bocamobile/board-mini/mini-base/design-files/MINI-BASE-A001-1.0.0-Pinout.pdf

Tabelle1

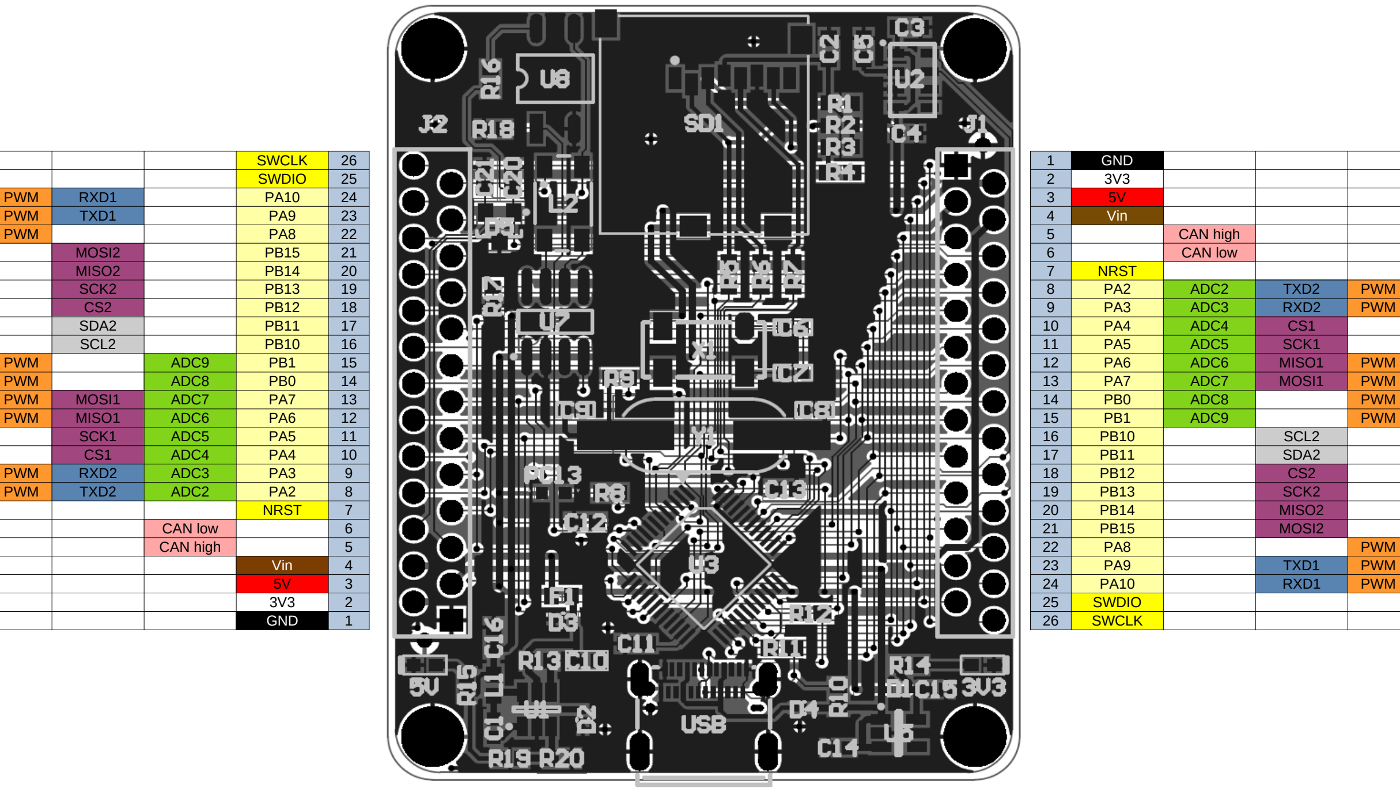
[picture p15: figure]
SWCLK; GND; SWDIO; PWM; RXD1; TXD1; Vin; CAN high; MOSI2; CAN low; MISO2; NRST; SCK2; ADC2; TXD2; ADC3; RXD2; SDA2; ADC4; SCL2; ADC5; SCK1; ADC9; ADC6; MISO1; ADC8; ADC7; MOSI1

Seite

1

PHYSICAL PIN
PIN NAME
CONTROL
ANALOG
USART
SPI
I2C
CAN BUS
PWM
