bocamobile/board-mini/mini-bike/documentation/Pinout_List.ods

Dashboard |  |  | ECU grey |  |  | ECU black
Pin | Description | Function | Pin | Description | Function | Pin | Description | Function
1 | B/R | Speed Sensor Vcc | 1 | G | Ignition Coil 4 | 1 | B/W | GND
2 | B/Lg | Fuel Pump Sig | 2 | B/W | GND | 2 | B/Br | Signal Ground ???
3 | Dbr | Meter Switch Down | 3 | W/R | rear connector thingy ??? | 3 | W/G | HO2 Sensor
4 | Dg | Meter Switch Up | 4 | B/Y | Clutch Switch / Starter Motor | 4 | Dg | IAT Sensor
5 | - | - | 5 | B/W | GND | 5 | B/Bl | ECT Sensor
6 | P | Speed Sensor Sig | 6 | Bl | Gear Position Switch / strange box thingy | 6 | B | TO Sensor
7 | Y/Bl | to ECM grey Pin 26 | 7 | B/W | GND | 7 | - | -
8 | B/G | to ECM black Pin 14 | 8 | O/Bl | Handlebar Switch UP | 8 | - | -
9 | G/Y | Oil Pressure Switch | 9 | Br/Y | to Dash Pin 10 | 9 | B/Lg | STVA
10 | Br/Y | to ECM grey Pin 9 | 10 | O/Bl | Immobilizer | 10 | G | STVA
11 | O/G | Fuse Box 4 (Signal) | 11 | Gr | rear connector thingy ??? | 11 | W | Steering Damper
12 | R/Bl | Fuse Box 5 (Fuel) | 12 | - | - | 12 | Br | Steering Damper
13 | Y | Headlight(HI) | 13 | Y | Ignition Coil 3 | 13 | Y/R | Cooling Fan Relay / Fuel Pump
14 | Bl/B | strange box thingy | 14 | Lg | Secondary Injector 1 | 14 | B/G | to Dash Pin 8
15 | B/Bl | Turn Signal Right | 15 | Lg/W | Secondary Injector 2 | 15 | P | Gear Position Switch
16 | B | Turn Signal left | 16 | Lg/B | Secondary Injector 3 | 16 | G/Bl | CKP Sensor
17 | - | - | 17 | Lg/Bl | Secondary Injector 4 | 17 | G/Y | AP Sensor
18 | - | - | 18 | W/G | Pair Control Valve | 18 | G/B | IAP Sensor
19 | - | - | 19 | Y/G | Starter Button / Starter Motor | 19 | Y/W | STP Sensor
20 | B/W | GND | 20 | R/Y | Immobilizer | 20 | - | -
 |  |  | 21 | Bl/W | rear connector thingy ??? | 21 | Bl/G | rear connector thingy ???
 |  |  | 22 | Bl/B | rear connector thingy ??? | 22 | Bl/Y | rear connector thingy ??? | Dealer Mode Switch???
 |  |  | 23 | O/R | Handlebar Switch DOWN | 23 | Y | EXCVA
 |  |  | 24 | Br | ISC Valve | 24 | R/B | EXCVA
 |  |  | 25 | W/Bl | Ignition Coil 1 | 25 | O/G | rear connector thingy ??? / distributor ???
 |  |  | 26 | B | Ignition Coil 2 | 26 | Y/Bl | to Dash Pin 7
 |  |  | 27 | Gr/W | Primary Injector 1 | 27 | R/Bl | Cooling Fan Relay / Fuse 5 (Fuel) / distributor ???
 |  |  | 28 | Gr/B | Primary Injector 2 | 28 | G/W | CKP Sensor
 |  |  | 29 | Gr/Y | Primary Injector 3 | 29 | B/Y | CMP Sensor
 |  |  | 30 | Gr/R | Primary Injector 4 | 30 | R | Sensor Supply ??? / rear connector thingy ???
 |  |  | 31 | G/R | Cooling Fan Relay | 31 | P/B | TP Sensor
 |  |  | 32 | W/B | HO2 Sensor | 32 | B/W | GND
 |  |  | 33 | Y/B | Cooling Fan Relay | 33 | P/W | STVA
 |  |  | 34 | Bl | ISC Valve | 34 | W/B | STVA
 |  |  | 35 | Y | ISC Valve | 35 | P | Speed Sensor
 |  |  | 36 | G | ISC Valve | 36 | B/R | EXCVA
