bocamobile/board-mini/mini-base/pictures/mini-base-rear.png

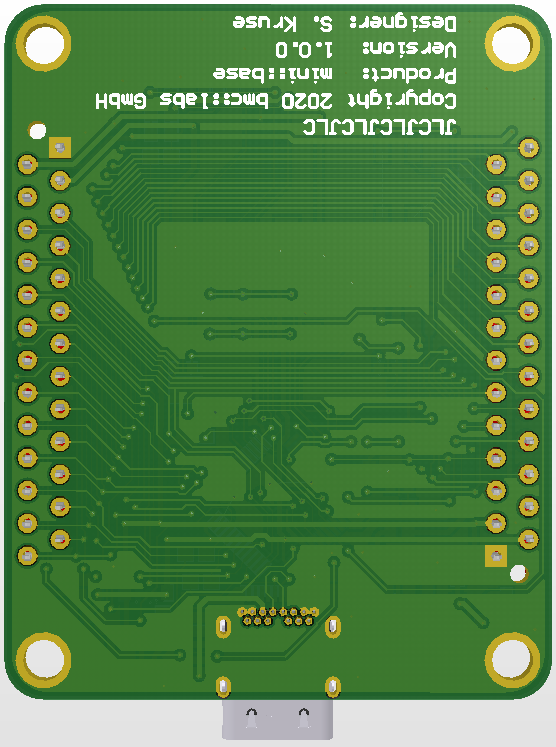
mini-base/pictures/mini-base-rear.png
