bocamobile/board-mini/mini-bike/documentation/gsxr 1000 pinout.jpg

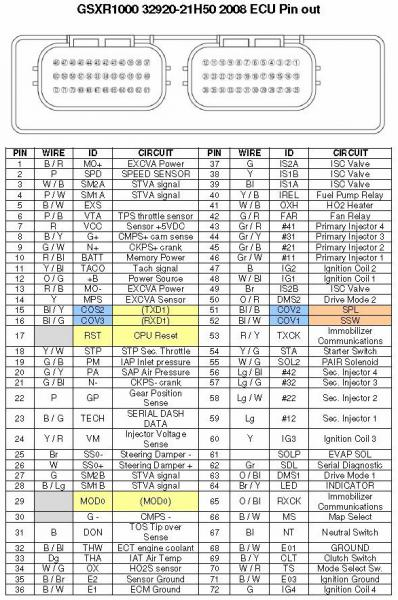
mini-bike/documentation/gsxr 1000 pinout.jpg
