bocamobile/board-mini/mini-grid/pictures/mini-grid-pinout.png

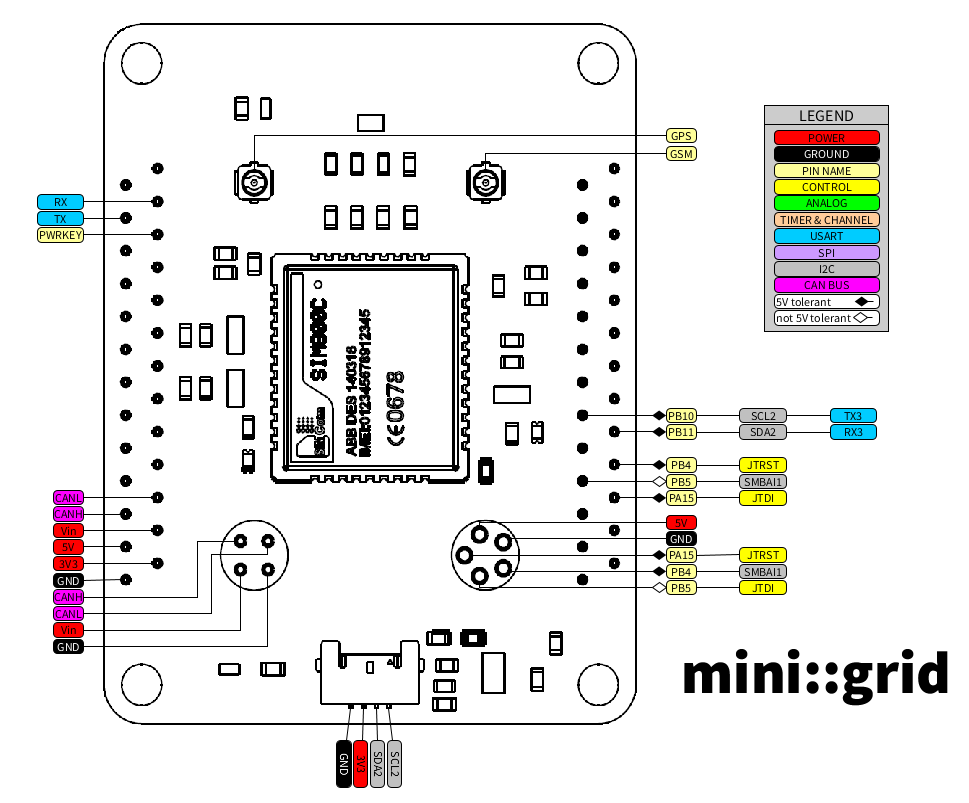
mini-grid/pictures/mini-grid-pinout.png
