bocamobile/board-mini/mini-grid/pictures/mini-grid-rear.png

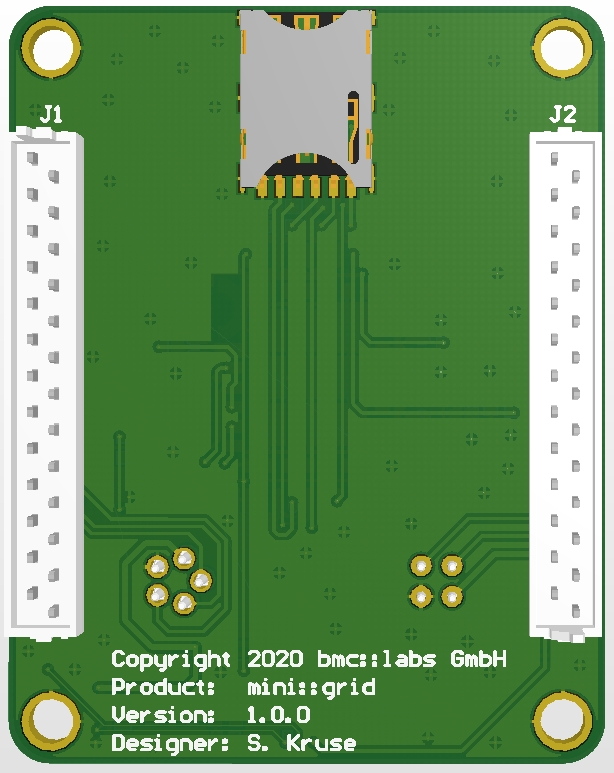
mini-grid/pictures/mini-grid-rear.png
