bocamobile/board-mini/mini-out/pictures/mini-out-pinout.png

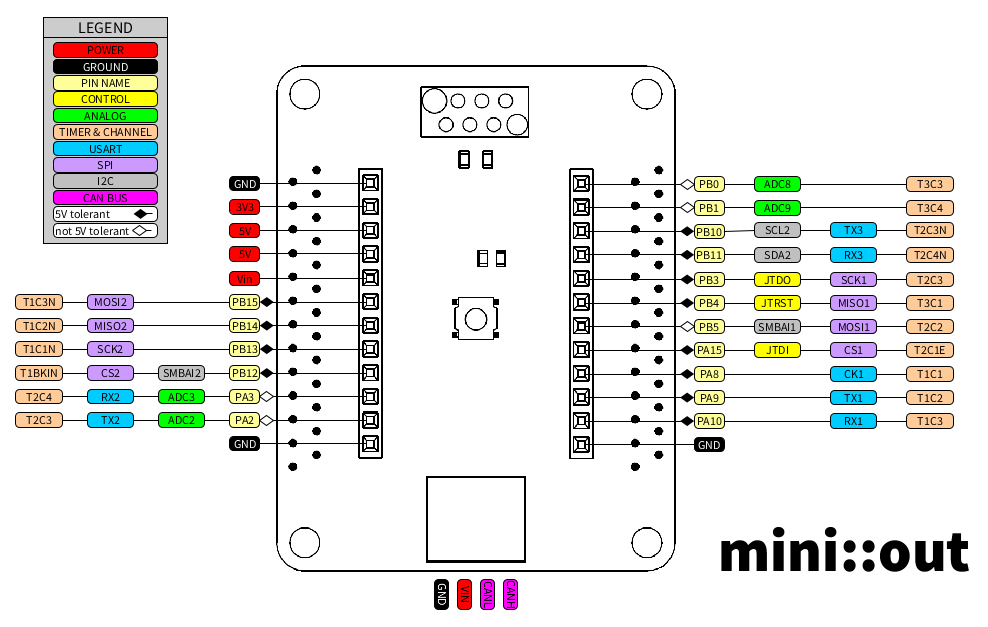
mini-out/pictures/mini-out-pinout.png
