bocamobile/board-mini/mini-out/pictures/mini-out-rear.png

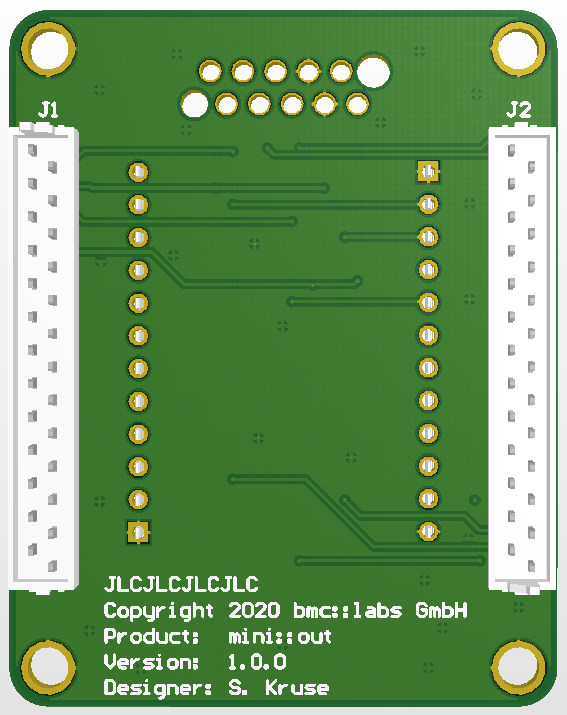
mini-out/pictures/mini-out-rear.png
