bocamobile/board-mini/mini-pit/pictures/mini-pit-pinout.png

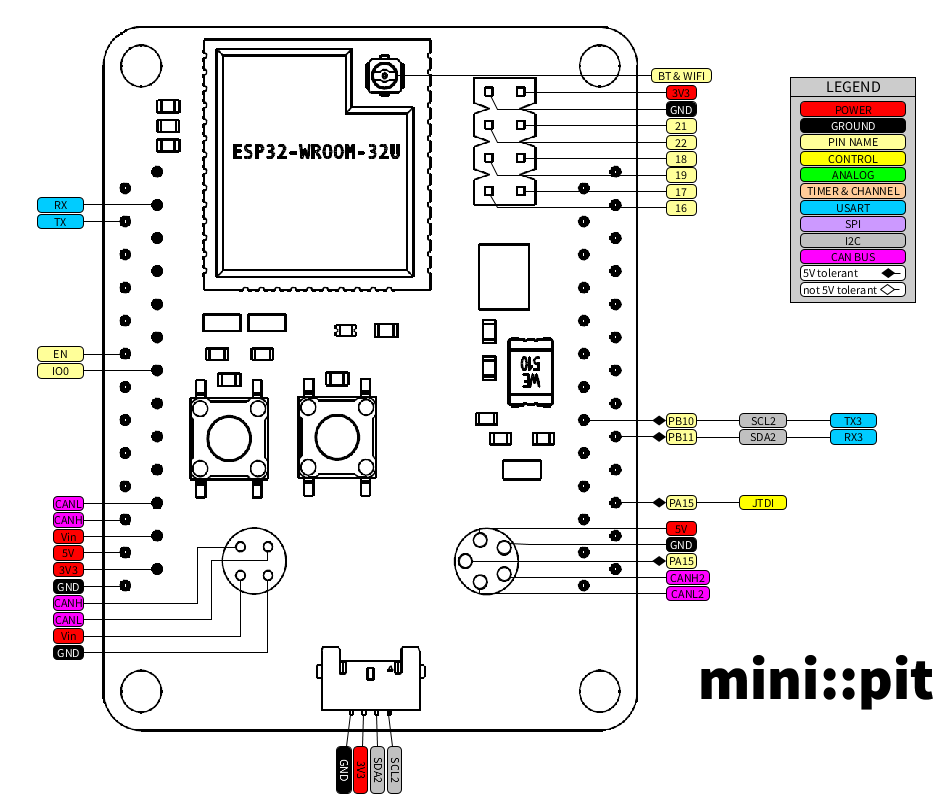
mini-pit/pictures/mini-pit-pinout.png
