bocamobile/board-mini/mini-pit/pictures/mini-pit-rear.png

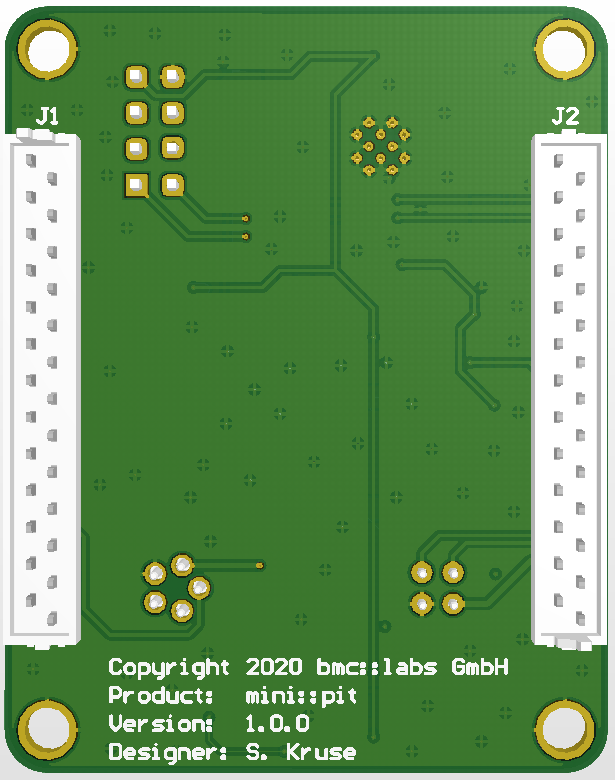
mini-pit/pictures/mini-pit-rear.png
