bocamobile/board-mini/mini-bike/production-files/MINI-BIKE-A001-1-0-0-BOM.xls

Comment | Description | Designator | Footprint | LibRef | Quantity
100nF | CL10 Series 0.1 uF 16 V ±10% Tolerance X7R SMT Multilayer Ceramic Capacitor | C1, C3 | PCB-ul7goghxin8pri3xfob7-1 | CMP-4ca9852e0e1c936e-3 | 2
0.47uF | CAP CER 0.47UF 16V 10% X5R 0603 | C2 | CAPC1608X90X35LL15T15 | CMP-126210-2 | 1
BAT54T1G | Schottky Barrier Diode, 2-Pin SOD-123, Pb-Free, Tape and Reel | D1 | ONSC-SOD-123-2-425-04_V | CMP-4964594-3 | 1
Würth Elektronik 690357102672 | Male THT Straight Connector without Latch and with Polarization WR-MM, 26 pins | J1, J2 | PCB-qkngfwumds4pa5a4mwtz-1 | CMP-cccf062e80c51308-1 | 2
Molex 34830-0801 | MX150 2x4 Dual Row Right-Angle Header, 8 Circuits, Keying Option A, Black, Solder Tail | J3 | PCB-1mpzuevuzgsguukkiqai-1 | CMP-e95d221892b7369a-5 | 1
510R | Thick Film Resistors - SMD 0603 510ohms 5% Tol | R1 | RESC1608X55X30LL15T15 | CMP-3654705-2 | 1
STMicroelectronics E-L9637D013TR | L9637 Series 36 V 2.3 mA Monolithic Bus Driver with ISO 9141 Interface - SOIC-8 | U1 | PCB-xa77rof92k761hx1v7rk-1 | CMP-9137583754b04ef0-1 | 1
