bocamobile/board-mini/mini-out/production-files/BOM-PartType-MINI-OUT-A001-1-0-0.xls

 |  | Component list |  | MINI::OUT
 |  | Source Data From: |  | MINI-OUT-A001-1-0-0.PrjPcb
 |  | Project: |  | MINI-OUT-A001-1-0-0.PrjPcb
 |  | Variant: |  | None
 |  | Report Date: | 04.11.2020 | 15:53:02
Description | Manufacturer Part Number | Designator | Quantity | Description | Comment
SQ Post Socket, Through-hole, Vertical, -55 to 105 degC, 2.54 mm Pitch, 12-Pin, Female, RoHS | SSW-112-01-T-S | J4, J5 | 2 | SQ Post Socket, Through-hole, Vertical, -55 to 105 degC, 2.54 mm Pitch, 12-Pin, Female, RoHS | SSW-112-01-T-S
Male THT Straight Connector without Latch and with Polarization WR-MM, 26 pins | 690357102672 | J1, J2 | 2 | Male THT Straight Connector without Latch and with Polarization WR-MM, 26 pins | Würth Elektronik 690357102672
WS-TASV SMD Tact Switch 6X6 mm | 430182043816 | RST | 1 | WS-TASV SMD Tact Switch 6X6 mm | 430182043816
Fixed Miniature Connectors, Spring Cage, Horizontal, SMD, 4 pos | 1702474 | J3 | 1 | Fixed Miniature Connectors, Spring Cage, Horizontal, SMD, 4 pos | Phoenix Contact 1702474
Res Thick Film 0603 22 Ohm 5% 1/10W ±200ppm/°C Molded SMD SMD Paper Tape on Plastic Reel |  | R1, R2 | 2 | Res Thick Film 0603 22 Ohm 5% 1/10W ±200ppm/°C Molded SMD SMD Paper Tape on Plastic Reel | Res1
REDFIT IDC SKEDD Connector WR-WST, pitch 2.54 mm, 10 pins |  | JTAG | 1 | REDFIT IDC SKEDD Connector WR-WST, pitch 2.54 mm, 10 pins | Würth Elektronik 490107671012
