bocamobile/board-mini/mini-grid/design-files/MINI-GRID-A001-1-0-0.xls

 |  | Component list |  | <Parameter ProjectName not found>
 |  | Source Data From: |  | MINI-GRID-A001-1-0-0.PrjPcb
 |  | Project: |  | MINI-GRID-A001-1-0-0.PrjPcb
 |  | Variant: |  | None
 |  | Report Date: | 05.11.2020 | 15:18:57
Description | Manufacturer Part Number | Designator | Quantity | Description | Comment
LED WHITE 0603 SMD |  | 1PPS, NET | 2 | LED WHITE 0603 SMD | Vishay VLMW1300-GS08
Soft Orange 0603 160º 15 mA 1.8 V 7.5 mcd Surface Mount LED | TLMO1000-GS08 | 4V | 1 | Soft Orange 0603 160º 15 mA 1.8 V 7.5 mcd Surface Mount LED | Vishay TLMO1000-GS08
0603 10 nF 50 V ±10 % Tolerance X7R SMT Multilayer Ceramic Capacitor | CC0603KRX7R9BB103 | C1 | 1 | 0603 10 nF 50 V ±10 % Tolerance X7R SMT Multilayer Ceramic Capacitor | 10nF
CAP CER 10UF 25V 20% X5R 0603 |  | C2 | 1 | CAP CER 10UF 25V 20% X5R 0603 | 10uF
0603 22 uF 4 V ±20 % Tolerance X5R SMT Multilayer Ceramic Capacitor | 06034D226MAT2A | C3 | 1 | 0603 22 uF 4 V ±20 % Tolerance X5R SMT Multilayer Ceramic Capacitor | AVX 06034D226MAT2A
CAP CER 0.1UF 50V X7R 0603 | CL10B104KB8NNNC | C4, C5, C6, C7, C8, C10 | 6 | CAP CER 0.1UF 50V X7R 0603 | 100nF
Chip Capacitor, 22 pF, +/- 5%, 50 V, -55 to 125 degC, 0603 (1608 Metric), RoHS, Tape and Reel | CC0603JRNPO9BN220 | C9, C11, C12 | 3 | Chip Capacitor, 22 pF, +/- 5%, 50 V, -55 to 125 degC, 0603 (1608 Metric), RoHS, Tape and Reel | Yageo CC0603JRNPO9BN220
Circular Connector, 712 Series, Receptacle, 5, Socket, Solder, Panel Mount Rohs Compliant: Yes |  | CH1 | 1 | Circular Connector, 712 Series, Receptacle, 5, Socket, Solder, Panel Mount Rohs Compliant: Yes | Binder 09 0416 90 05
Schottky Barrier Diode, 2-Pin SOD-123, Pb-Free, Tape and Reel | BAT54T1G | D1 | 1 | Schottky Barrier Diode, 2-Pin SOD-123, Pb-Free, Tape and Reel | BAT54T1G
Quad Array ESD Protection Diodes with Low Clamping Voltage, 5-Pin SC70, Pb-Free, Tape and Reel | SMF05T1G | D2 | 1 | Quad Array ESD Protection Diodes with Low Clamping Voltage, 5-Pin SC70, Pb-Free, Tape and Reel | SMF05T1G
1.00mm Pitch Pico-LockT Surface Mount Header, Right Angle, 1.50mm Height, Positive Side Locks, 4 Circuits | 503763-0491 | DISPLAY | 1 | 1.00mm Pitch Pico-LockT Surface Mount Header, Right Angle, 1.50mm Height, Positive Side Locks, 4 Circuits | Molex 503763-0491
Rf Connectors / Coaxial Connectors SMT Ml Rec Au 50 Ohm W/anti Sldr Wckng Rl | U.FL-R-SMT-1(10) | GPS, GSM | 2 | Rf Connectors / Coaxial Connectors SMT Ml Rec Au 50 Ohm W/anti Sldr Wckng Rl | Hirose U.FL-R-SMT-1(10)
Male THT Straight Connector without Latch and with Polarization WR-MM, 26 pins | 690357102672 | J1, J2 | 2 | Male THT Straight Connector without Latch and with Polarization WR-MM, 26 pins | Würth Elektronik 690357102672
Conn, Nano Sim, Push-Pull, 6pos | 693043020611 | J3 | 1 | Conn, Nano Sim, Push-Pull, 6pos | NanoSIM Conn
POWER LINE IND, 4.7UH, 500MA, 20%; Product Range: TDK - GLFR Series; Inductance: 4.7 |  | L1 | 1 | POWER LINE IND, 4.7UH, 500MA, 20%; Product Range: TDK - GLFR Series; Inductance: 4.7 | 4.7uH
Inductor RF Chip Unshielded Multi-Layer 27nH 5% 100MHz 12Q-Factor Ceramic 500mA 540mOhm DCR 0603 T/R | LQG18HN27NJ00D | L2 | 1 | Inductor RF Chip Unshielded Multi-Layer 27nH 5% 100MHz 12Q-Factor Ceramic 500mA 540mOhm DCR 0603 T/R | Inductor
Circular Connector, 712 Series, Receptacle, 4, Socket, Solder, Panel Mount Rohs Compliant: Yes | 09 0412 80 04 | PWR | 1 | Circular Connector, 712 Series, Receptacle, 4, Socket, Solder, Panel Mount Rohs Compliant: Yes | Binder 09 0412 90 04
KSC Series NPN 200 mW 50 V 100 mA Surface Mount Epitaxial Transistor - SOT-23 | KSC1623LMTF | Q1, Q2, Q3 | 3 | KSC Series NPN 200 mW 50 V 100 mA Surface Mount Epitaxial Transistor - SOT-23 | NPN
Res General Purpose Thick Film 0603 100k Ohm 1% 1/10W ±100ppm/°C Molded Paper T/R | RC0603FR-07100KL | R1 | 1 | Res General Purpose Thick Film 0603 100k Ohm 1% 1/10W ±100ppm/°C Molded Paper T/R | 100k
Res Thick Film 1.6 x 0.8 mm 49.9K Ohm 1% 0.1W(1/10W) 100ppm/ C Molded SMD Paper T/R | RC0603FR-0749K9L | R2 | 1 | Res Thick Film 1.6 x 0.8 mm 49.9K Ohm 1% 0.1W(1/10W) 100ppm/ C Molded SMD Paper T/R | RC0603FR-0749K9L
Thick Film Resistors - SMD 0603 12.7Kohms 1% Tol | ERJ-3EKF1272V | R3 | 1 | Thick Film Resistors - SMD 0603 12.7Kohms 1% Tol | Panasonic ERJ-3EKF1272V
RCA Series 0603 0.1 W 0 O Jumper Surface Mount Thick Film Chip Resistor | RCA06030000ZSEA | R4, R5 | 2 | RCA Series 0603 0.1 W 0 O Jumper Surface Mount Thick Film Chip Resistor | 0 O
Res Thick Film 0603 4.7K Ohm 1% 1/10W ±100ppm/°C Molded SMD Paper T/R |  | R6, R10, R13 | 3 | Res Thick Film 0603 4.7K Ohm 1% 1/10W ±100ppm/°C Molded SMD Paper T/R | 4k7
Surface Mount Thick Film Resistor, RC Series, 47 kohm, 100 mW, - 1%, 50 V, 0603 [1608 Metric] |  | R7, R12, R14 | 3 | Surface Mount Thick Film Resistor, RC Series, 47 kohm, 100 mW, - 1%, 50 V, 0603 [1608 Metric] | 47k
Res General Purpose Thick Film 0603 10K Ohm 1% 1/10W ±100ppm/°C Molded SMD Paper T/R |  | R8 | 1 | Res General Purpose Thick Film 0603 10K Ohm 1% 1/10W ±100ppm/°C Molded SMD Paper T/R | 10K 0603
RES SMD 43 OHM 5% 1/10W 0603 | RC0603JR-0743RL | R9, R11 | 2 | RES SMD 43 OHM 5% 1/10W 0603 | Yageo RC0603JR-0743RL
PANASONIC ERJPA3F22R0V RESISTOR, ERJP, 22 OHM, 0603, 0.25W, 1% | ERJPA3F22R0V | R15, R17, R18 | 3 | PANASONIC ERJPA3F22R0V RESISTOR, ERJP, 22 OHM, 0603, 0.25W, 1% | Panasonic ERJPA3F22R0V
Thick Film Resistors - SMD 1/10watts 120ohms 1% | RK73H1JTTD1200F | R19 | 1 | Thick Film Resistors - SMD 1/10watts 120ohms 1% | KOA Speer RK73H1JTTD1200F
RC Series 0603 0.1 W 10 Ohms 5% ±100 ppm/°C SMT Thick Film Chip Resistor | RC0603JR-0710RL | R20 | 1 | RC Series 0603 0.1 W 10 Ohms 5% ±100 ppm/°C SMT Thick Film Chip Resistor | YAGEO RC0603JR-0710RL
Conv DC-DC Single Step Down 4.5V to 24V 6-Pin SOT-23 T/R |  | U1 | 1 | Conv DC-DC Single Step Down 4.5V to 24V 6-Pin SOT-23 T/R | Monolithic Power Systems MP2359DT-LF-P
Quad Band GSM/GPRS+GNSS Module 850MHz/900MHz/1800MHz/1900MHz 3.4V to 4.4V 77-Pin SMD |  | U2 | 1 | Quad Band GSM/GPRS+GNSS Module 850MHz/900MHz/1800MHz/1900MHz 3.4V to 4.4V 77-Pin SMD | Simcom SIM868
