bocamobile/board-mini/mini-pit/design-files/MINI-PIT-A001-1-0-0.xls

 |  | Component list |  | <Parameter ProjectName not found>
 |  | Source Data From: |  | MINI-PIT-A001-1-0-0.PrjPcb
 |  | Project: |  | MINI-PIT-A001-1-0-0.PrjPcb
 |  | Variant: |  | None
 |  | Report Date: | 05.11.2020 | 15:23:32
Description | #Column Name Error:Manufacturer Part Number | Designator | Quantity | Description | Comment
WS-TASV SMD Tact Switch 6X6 mm |  | boot, EN | 2 | WS-TASV SMD Tact Switch 6X6 mm | 430182043816
CAP CER 0.1UF 50V X7R 0603 |  | C1, C2, C5, C6 | 4 | CAP CER 0.1UF 50V X7R 0603 | 100nF
CAP CER 1000PF 50V 10% X7R 0603 |  | C3, C4 | 2 | CAP CER 1000PF 50V 10% X7R 0603 | Murata GCM188R71H102KA37D
Circular Connector, 712 Series, Receptacle, 5, Socket, Solder, Panel Mount Rohs Compliant: Yes |  | CH1 | 1 | Circular Connector, 712 Series, Receptacle, 5, Socket, Solder, Panel Mount Rohs Compliant: Yes | Binder 09 0416 90 05
PESD2CAN Series 2 Channel Bi-Directional CAN Bus ESD Protection Diode - SOT-23-3 |  | D1 | 1 | PESD2CAN Series 2 Channel Bi-Directional CAN Bus ESD Protection Diode - SOT-23-3 | NXP Semiconductors PESD2CAN,215
1.00mm Pitch Pico-LockT Surface Mount Header, Right Angle, 1.50mm Height, Positive Side Locks, 4 Circuits |  | DISPLAY | 1 | 1.00mm Pitch Pico-LockT Surface Mount Header, Right Angle, 1.50mm Height, Positive Side Locks, 4 Circuits | Molex 503763-0491
Male THT Straight Connector without Latch and with Polarization WR-MM, 26 pins |  | J1, J2 | 2 | Male THT Straight Connector without Latch and with Polarization WR-MM, 26 pins | Würth Elektronik 690357102672
Conn Unshrouded Header HDR 8 POS 2.54mm Solder ST Thru-Hole Carton |  | J3 | 1 | Conn Unshrouded Header HDR 8 POS 2.54mm Solder ST Thru-Hole Carton | TE Connectivity 5-146256-4
SMD Common Mode Line Filter WE-SL1, L = 100 µH |  | L1 | 1 | SMD Common Mode Line Filter WE-SL1, L = 100 µH | 744212101
Circular Connector, 712 Series, Receptacle, 4, Socket, Solder, Panel Mount Rohs Compliant: Yes |  | PWR | 1 | Circular Connector, 712 Series, Receptacle, 4, Socket, Solder, Panel Mount Rohs Compliant: Yes | Binder 09 0412 90 04
KSC Series NPN 200 mW 50 V 100 mA Surface Mount Epitaxial Transistor - SOT-23 |  | Q1, Q2 | 2 | KSC Series NPN 200 mW 50 V 100 mA Surface Mount Epitaxial Transistor - SOT-23 | ON Semiconductor KSC1623LMTF
Res General Purpose Thick Film 0603 10K Ohm 1% 1/10W ±100ppm/°C Molded SMD Paper T/R |  | R1, R2, R6 | 3 | Res General Purpose Thick Film 0603 10K Ohm 1% 1/10W ±100ppm/°C Molded SMD Paper T/R | Yageo RC0603FR-0710KL
Thick Film Resistors - SMD 1/10W 100ohm 5% |  | R3 | 1 | Thick Film Resistors - SMD 1/10W 100ohm 5% | Yageo AC0603JR-07100RL
Metal Film Resistors 10K OHM .1% 25PPM |  | R4 | 1 | Metal Film Resistors 10K OHM .1% 25PPM | Panasonic ERA-3YEB103V
Surface Mount Thick Film Resistor, Aec-Q200 Erj Series, 1 Kohm, 200 Mw, - 1%, 150 V |  | R5 | 1 | Surface Mount Thick Film Resistor, Aec-Q200 Erj Series, 1 Kohm, 200 Mw, - 1%, 150 V | Res1
RESISTOR, 681R, 0603, FULL REEL |  | R8 | 1 | RESISTOR, 681R, 0603, FULL REEL | Panasonic ERA3AEB6810V
Automotive Catalog 3.3 V CAN Transceiver, 17 mA, -40 to 125 degC, 8-pin SOIC (D), Green (RoHS & no Sb/Br) |  | U1 | 1 | Automotive Catalog 3.3 V CAN Transceiver, 17 mA, -40 to 125 degC, 8-pin SOIC (D), Green (RoHS & no Sb/Br) | SN65HVD230QD
Relay SSR 15mA 1.4V DC-IN DC-OUT 4-Pin SO T/R |  | U2 | 1 | Relay SSR 15mA 1.4V DC-IN DC-OUT 4-Pin SO T/R | TLP175A
SMD Module, ESP32-D0WD, 32MBITS Spi Flash, Uart Mode, U.fl Antenna Connector |  | U3 | 1 | SMD Module, ESP32-D0WD, 32MBITS Spi Flash, Uart Mode, U.fl Antenna Connector | Espressif Systems ESP32-WROOM-32U
LED WHITE 0603 SMD |  | USR LED | 1 | LED WHITE 0603 SMD | Vishay VLMW1300-GS08
