bocamobile/board-mini/mini-grid/design-files/MINI-GRID-A001-1-0-0.PDF

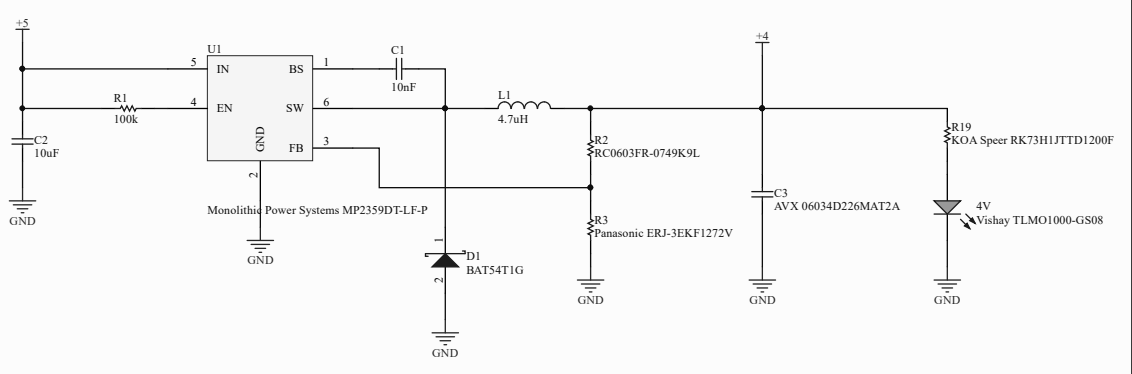
[picture p24: page 1]
Sheet o; ian Kru; GND 2; wer Sy; tems MP2; ic ERJ-3; A Speer RK

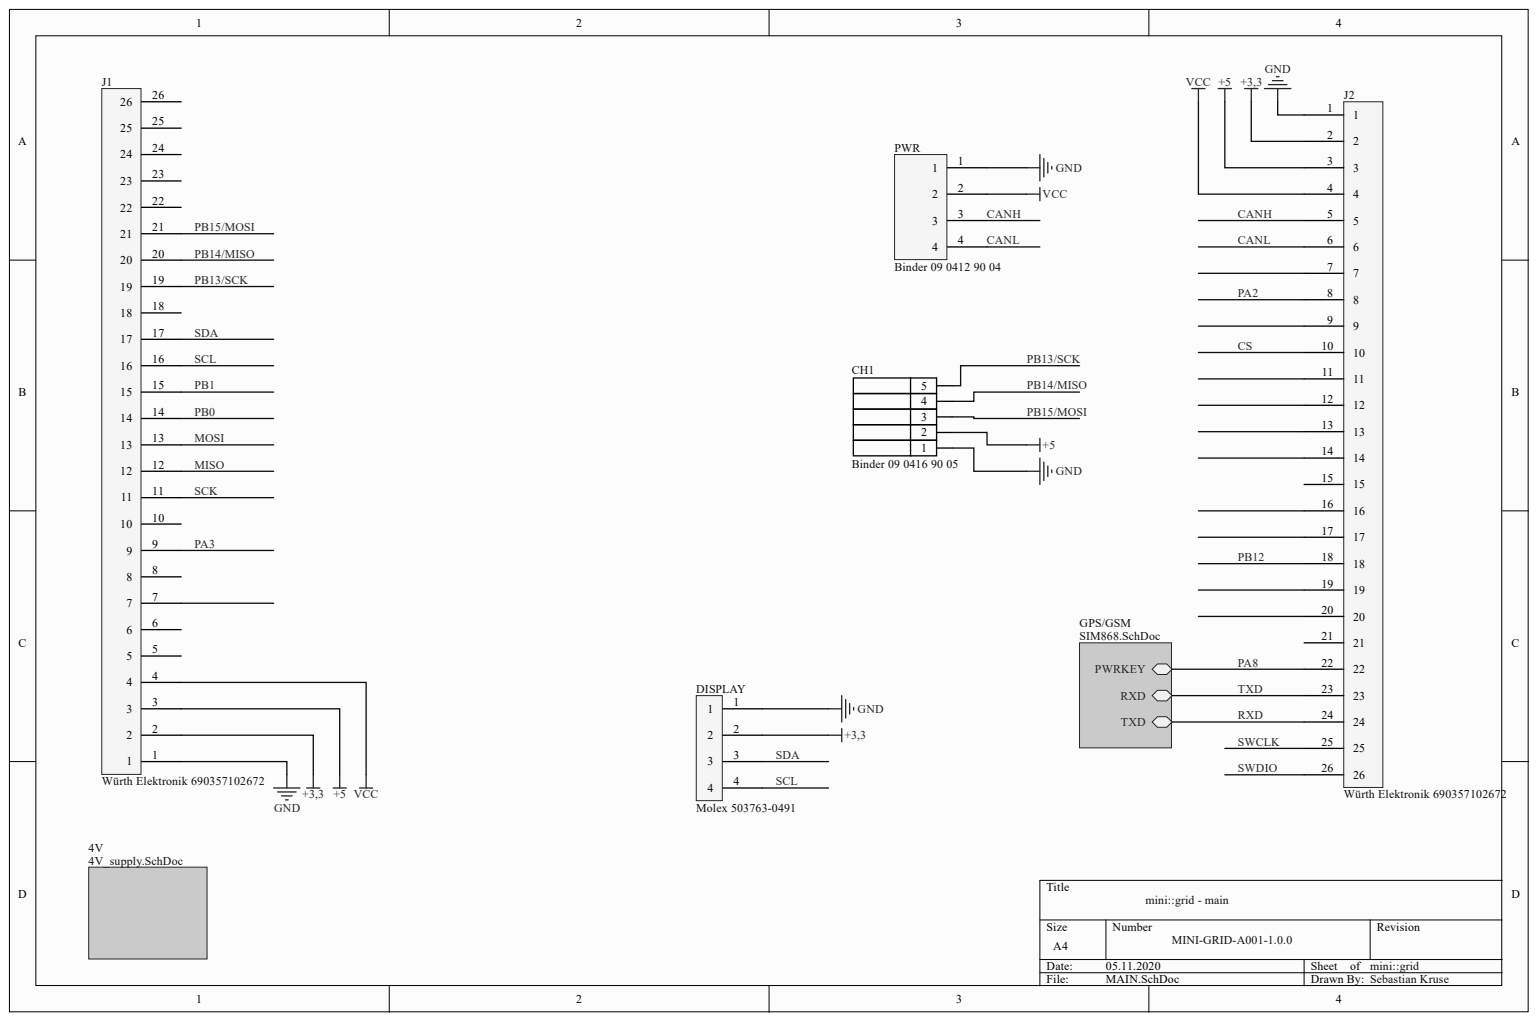
[picture p25: page 2]
d - mai; VCC +5 +3,3; lex 5; der 0

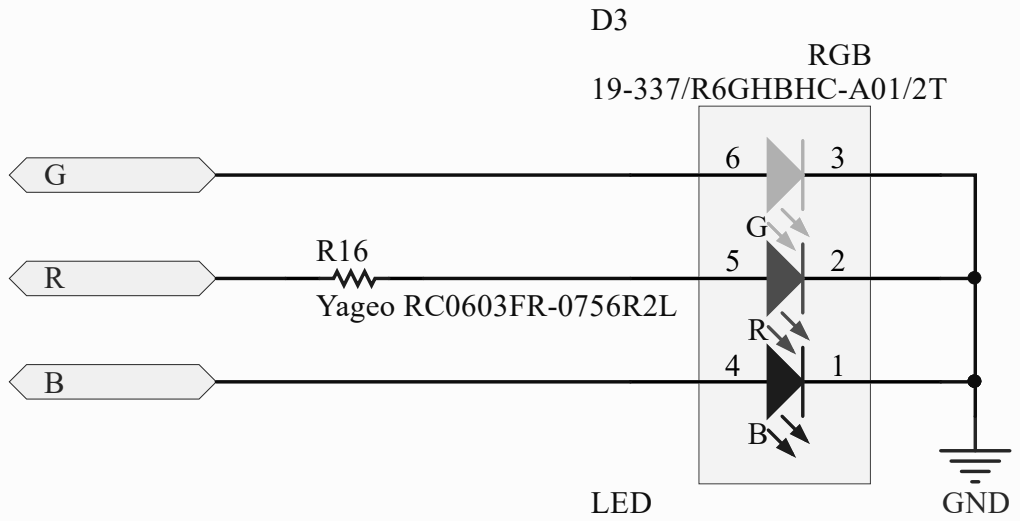
[picture p26: page 3]
Date:; Sheet of; File:; RGB.SchDoc; Drawn By:; Yageo RC0603FR-0756R2L

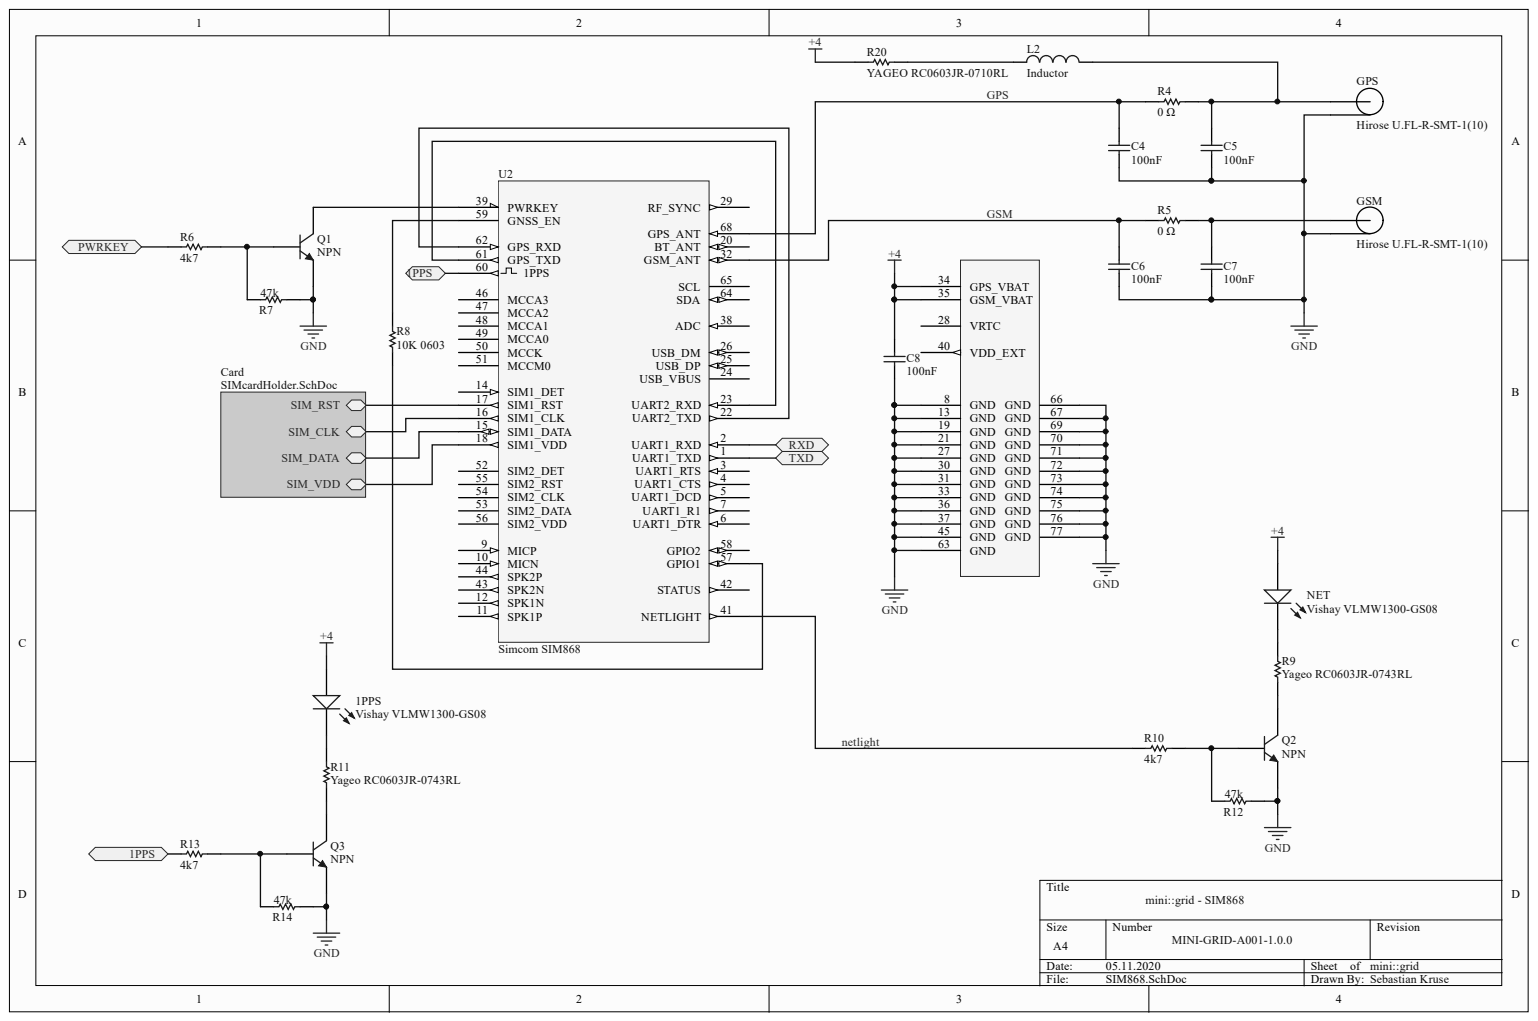
[picture p27: page 4]

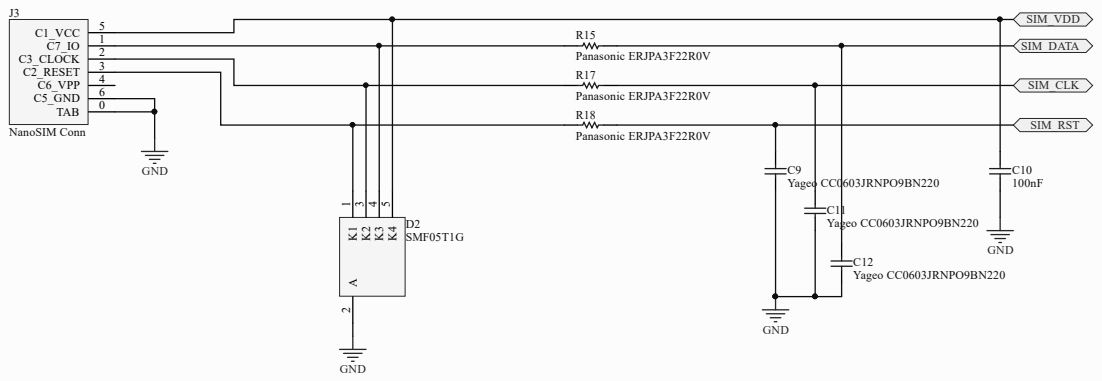
[picture p28: page 5]
C9 Yageo CC0; Yageo CC0; d - SIM Card H; 3 C3_CLOCK; oSIM Co; ic ERJ

6 C6_VPP 4

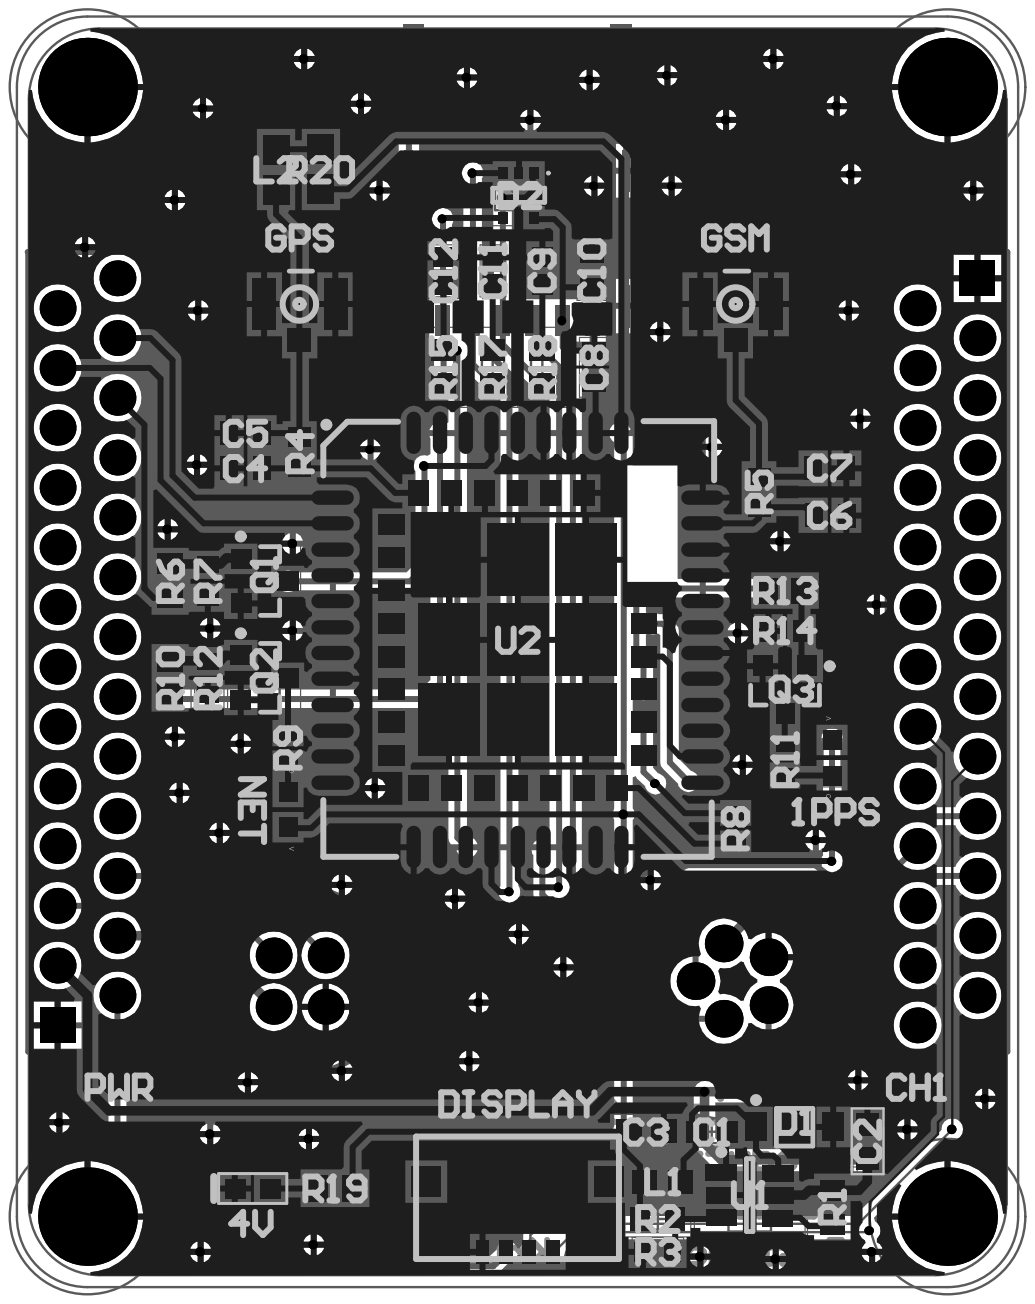
[picture p29: page 6]
