bocamobile/board-mini/mini-pit/design-files/MINI-PIT-A001-1-0-0.PDF

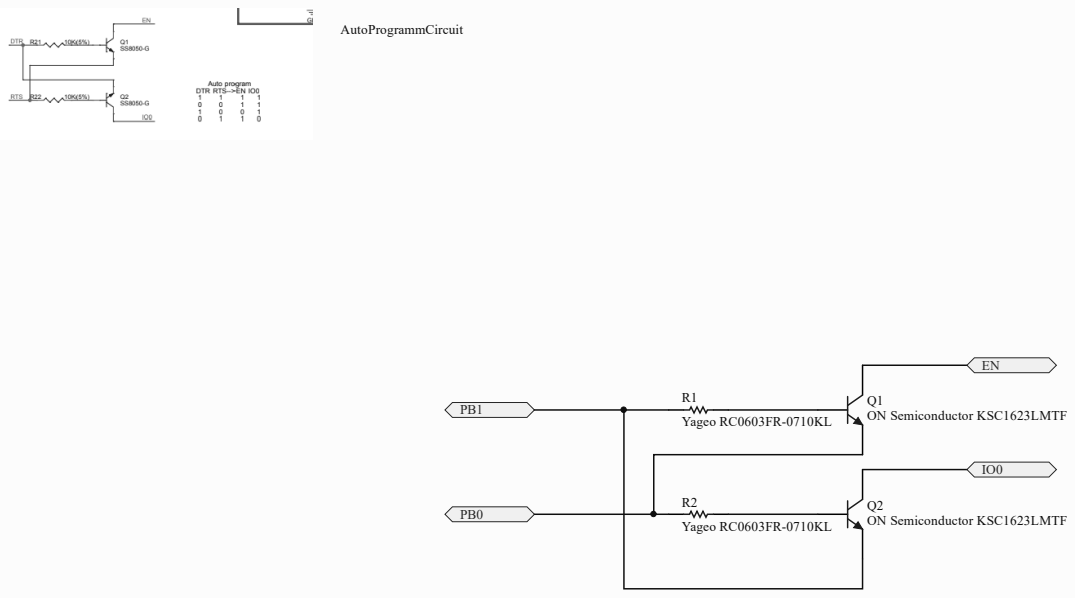
[picture p30: page 1]
Sheet o; N Semico; or KSC1; R1 Yageo RC0; R2 Yageo RC0; ian Kru

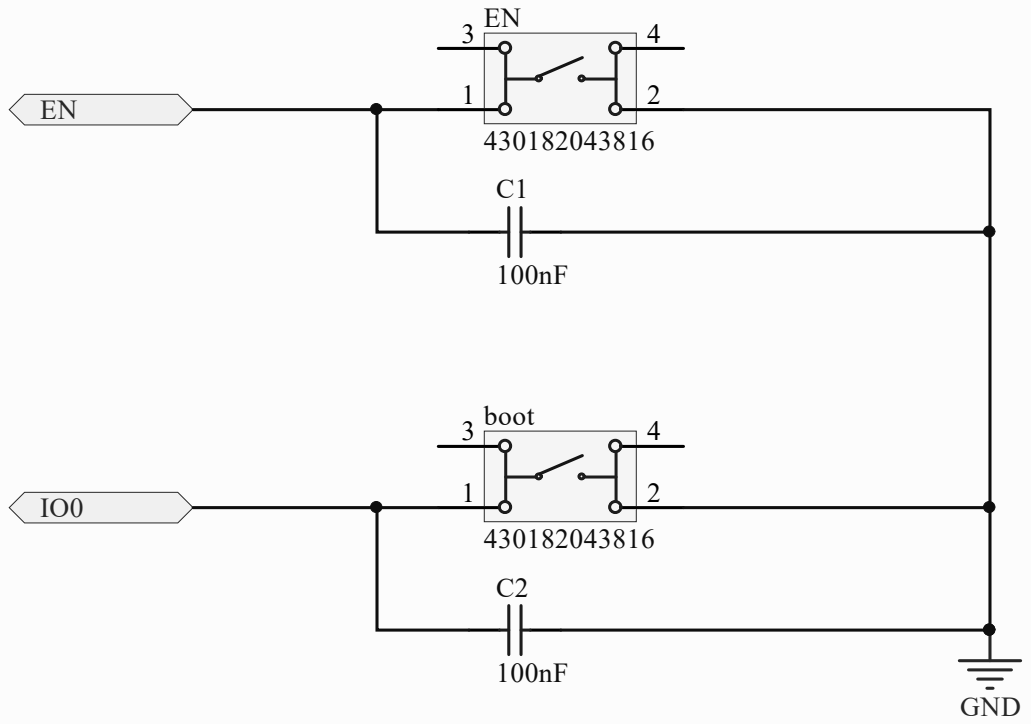
[picture p31: page 2]
Date:; Sheet of; File:; buttons.SchDoc; Drawn By:; Sebastian Kruse; 4 boot

mini::pit - buttons

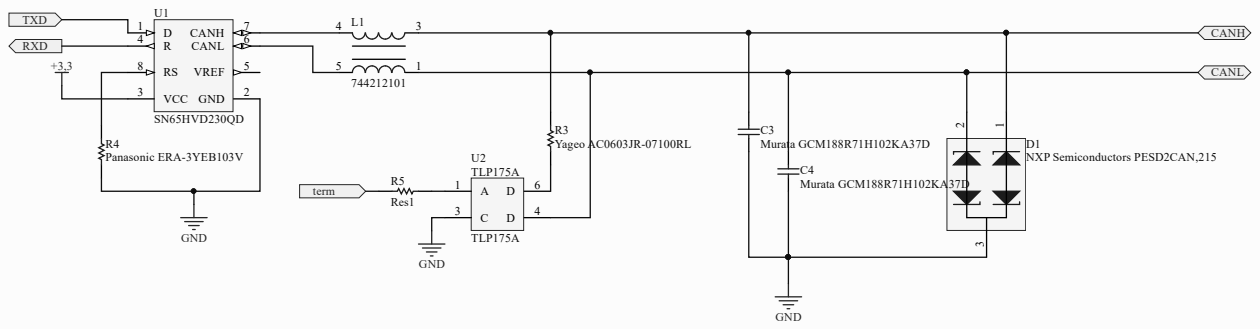
[picture p32: page 3]
P Semico; ors PESD; Murata GCM1; ic ERA-3; 6 CANH; R3 Yageo

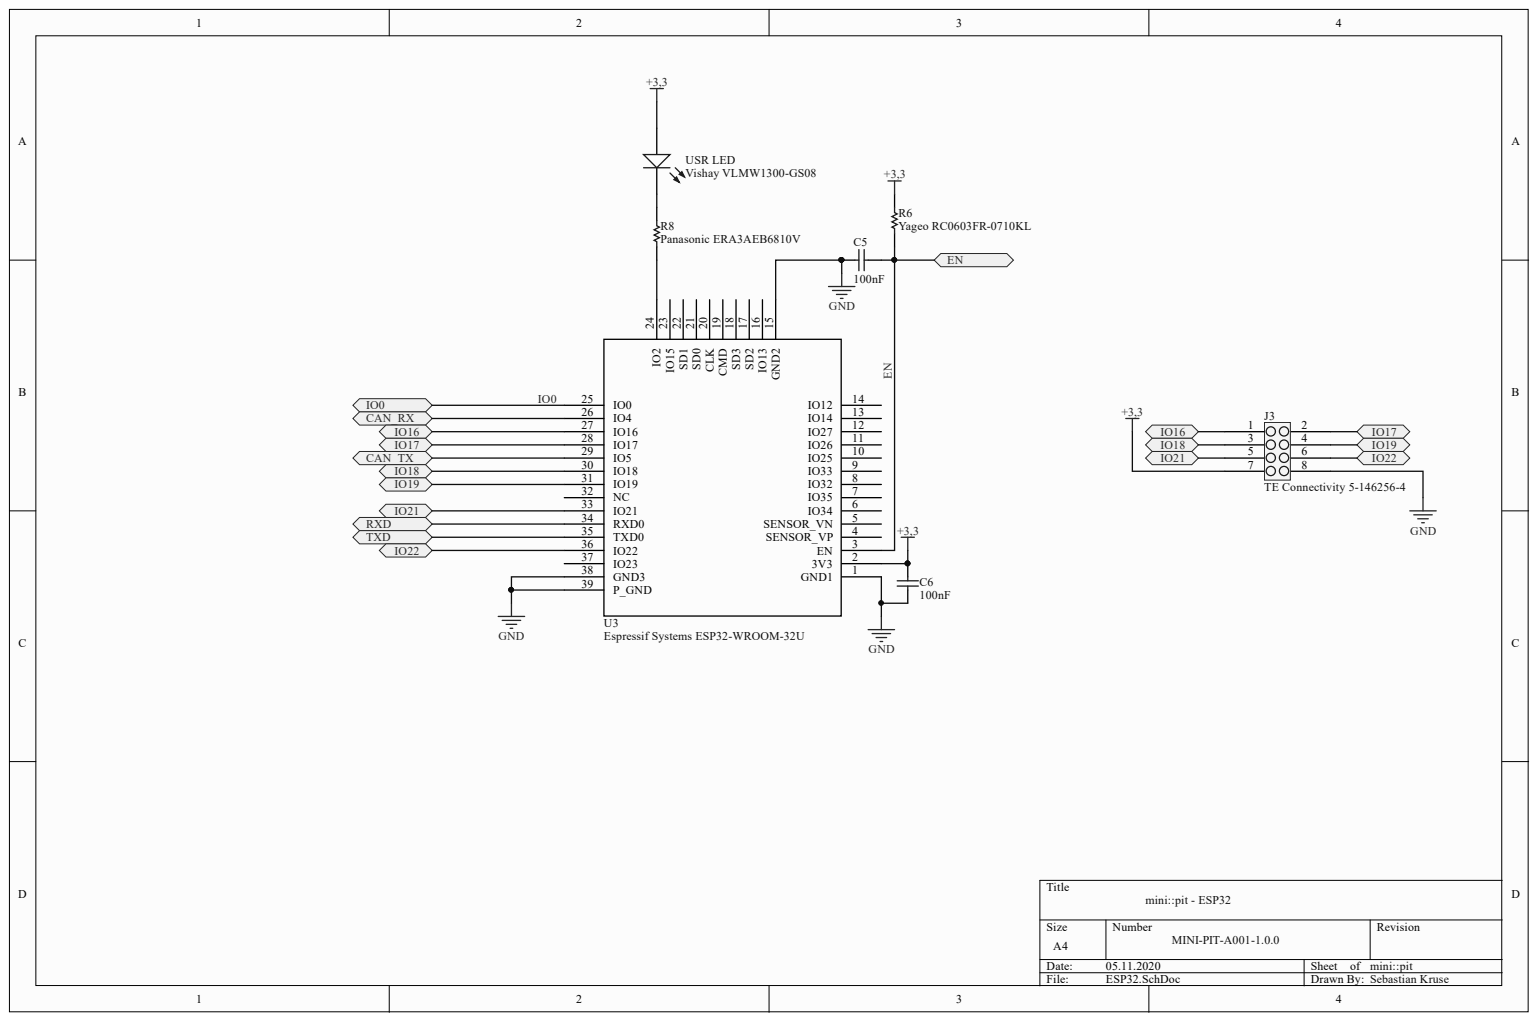
[picture p33: page 4]
File:; ESP32.SchDoc; Drawn By:; Yageo RC0603FR-0710KL; mini::pit - ESP32; GND1; 3 SENSOR_VP; 4 SENSOR_VN; GND2 15 IO13 16 SD2 17 SD3 18 CMD 19 CLK 20 SD0 21 SD1 22 IO15 23 IO2 24; IO0 25 IO4 26 IO16 27 IO17 28 IO5 29 IO18 30 IO19 31 NC 32 IO21 33 RXD0 34 TXD0 35 IO22 36 IO23 37 GND3 38 P_GND 39; USR LED Vishay VLMW1300-GS08; Panasonic ERA3AEB6810V; TE Connectivity 5-146256-4

Espressif Systems ESP32-WROOM-32U

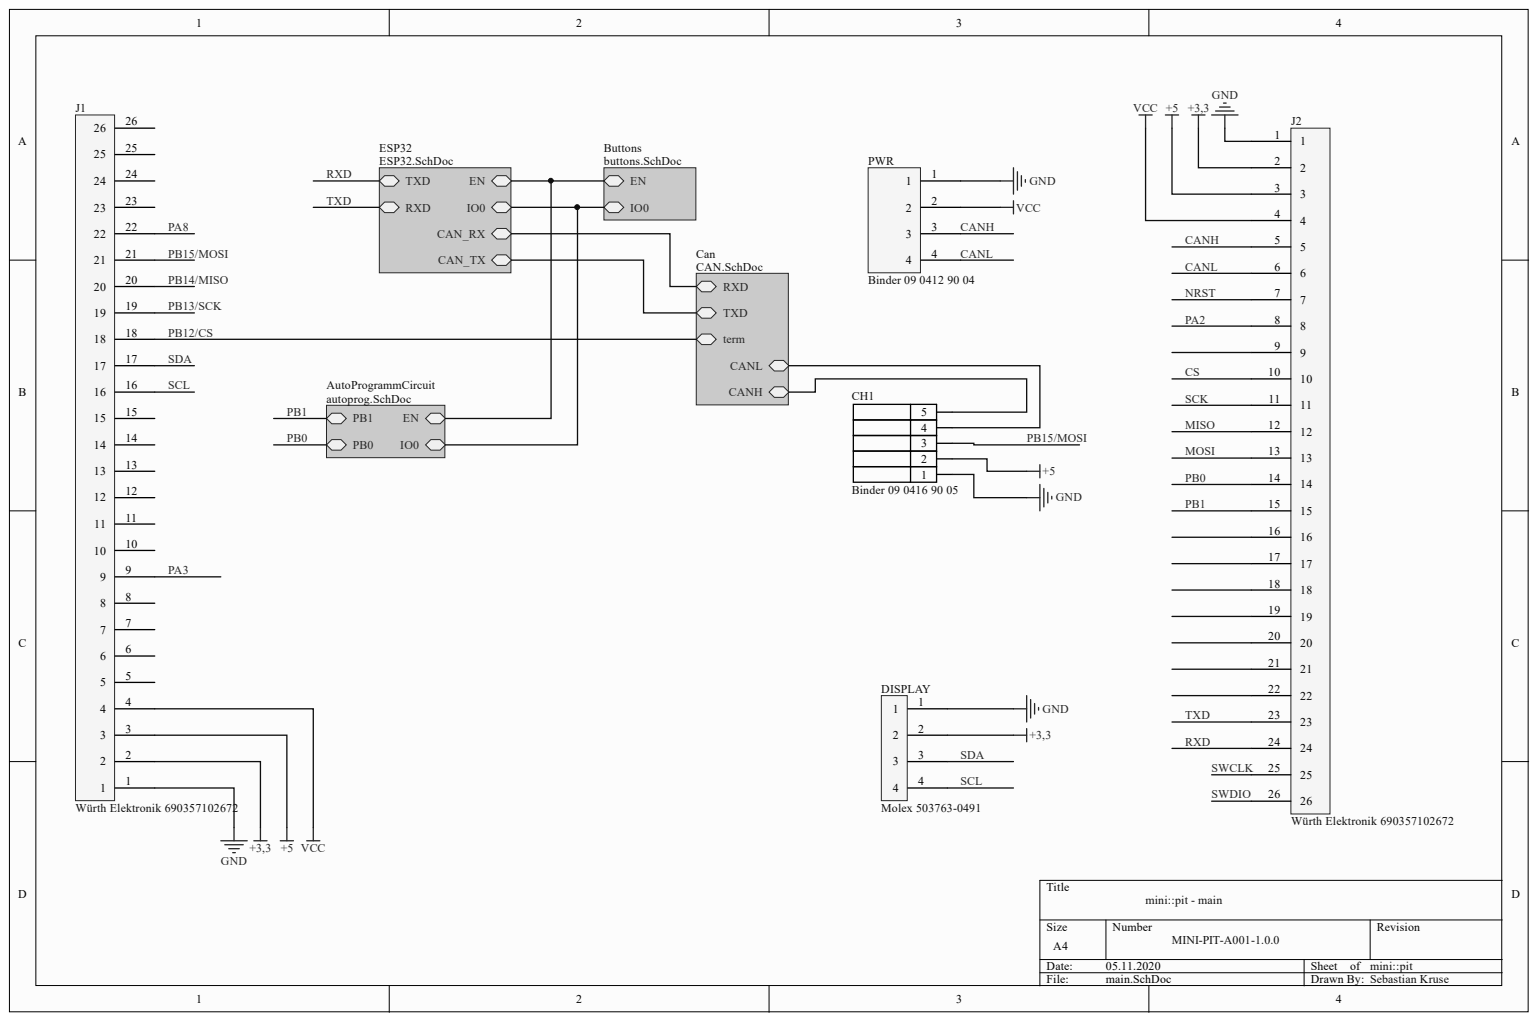
[picture p34: page 5]
VCC +5 +3,3; NRST PA2; ian Kru; t - mai; SCL PA8; lex 5; der 0

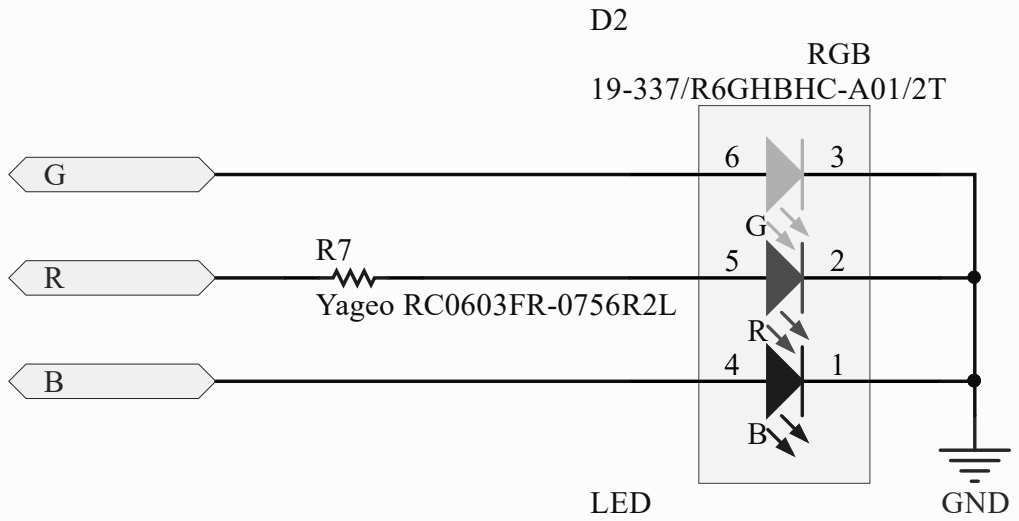
[picture p35: page 6]
File:; RGB.SchDoc; Drawn By:; Yageo RC0603FR-0756R2L

mini::pit - RGB

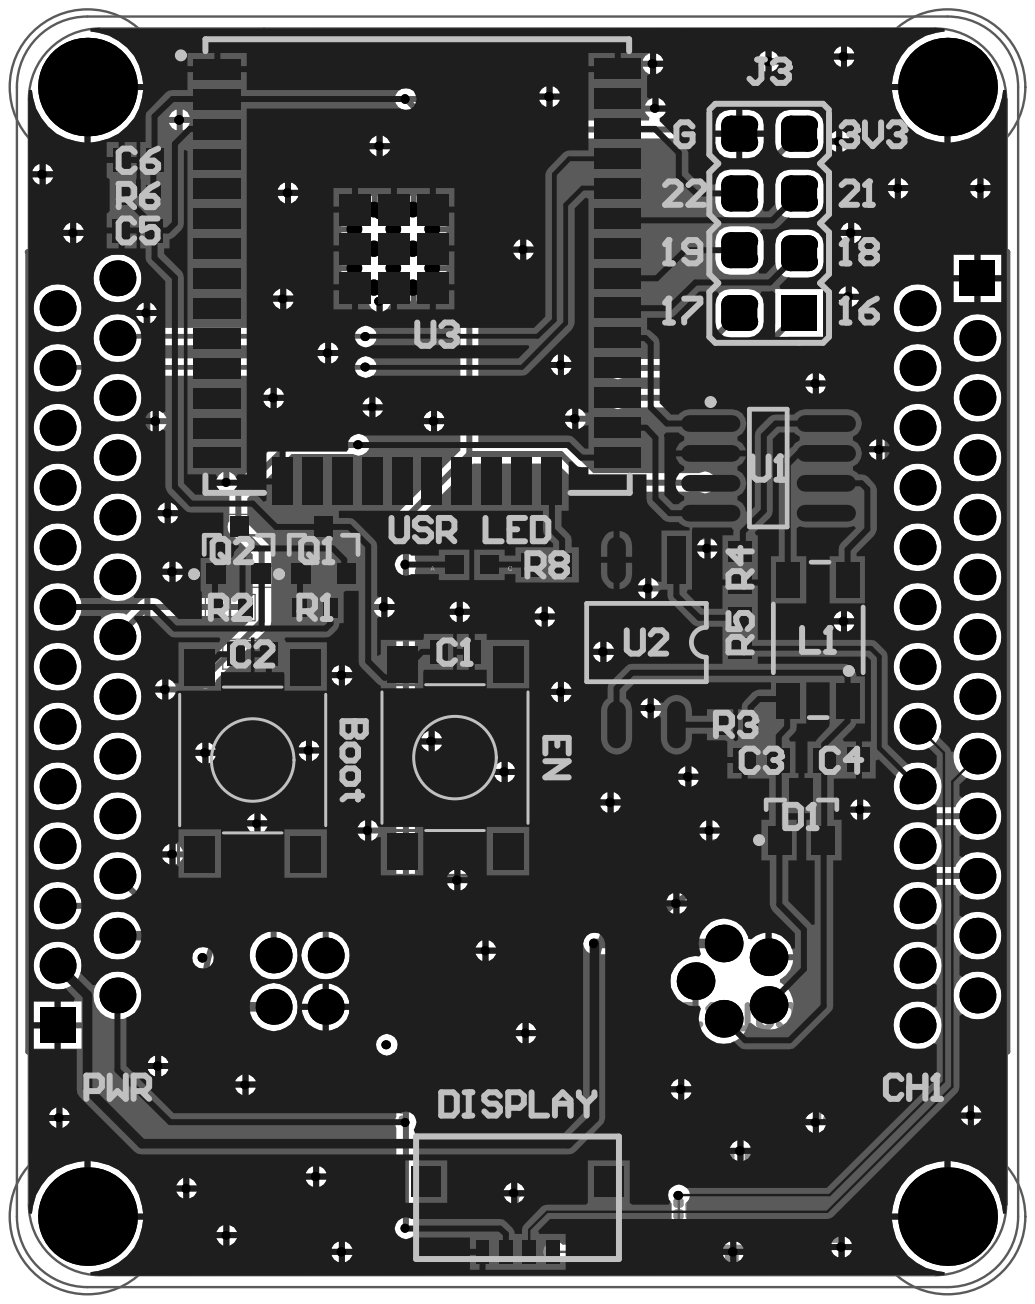
[picture p36: page 7]
