bocamobile/board-mini/mini-bike/design-files/MINI-BIKE-A001-1-0-0.PDF

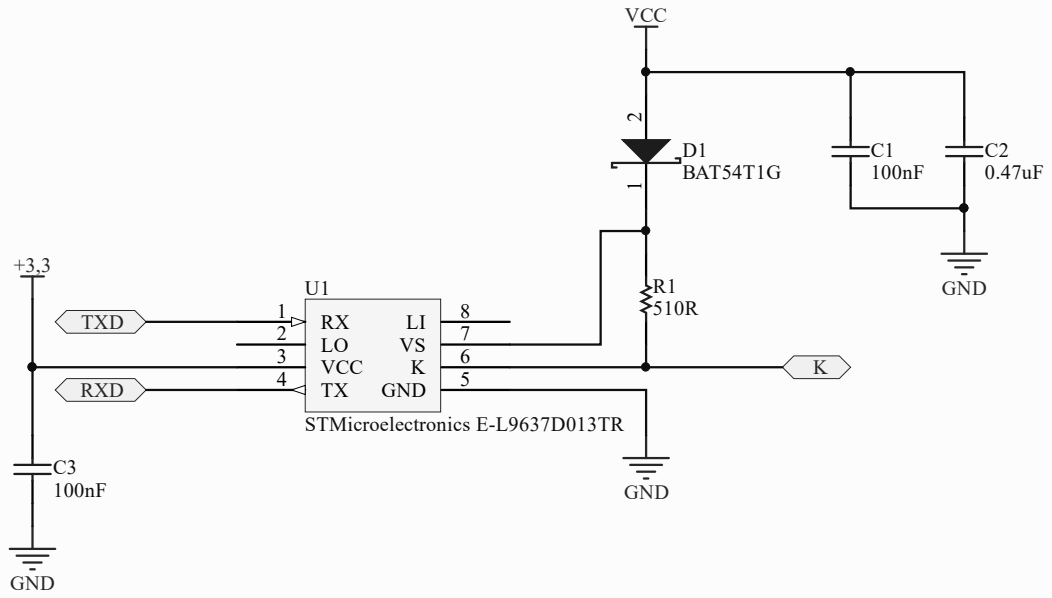
[picture p47: page 1]
Date:; Sheet of; File:; K-line.SchDoc; Drawn By:; TXD; LO 2 VCC 3 TX 4; STMicroelectronics E-L9637D013TR; Sebastian Kruse

mini::bike - K-line

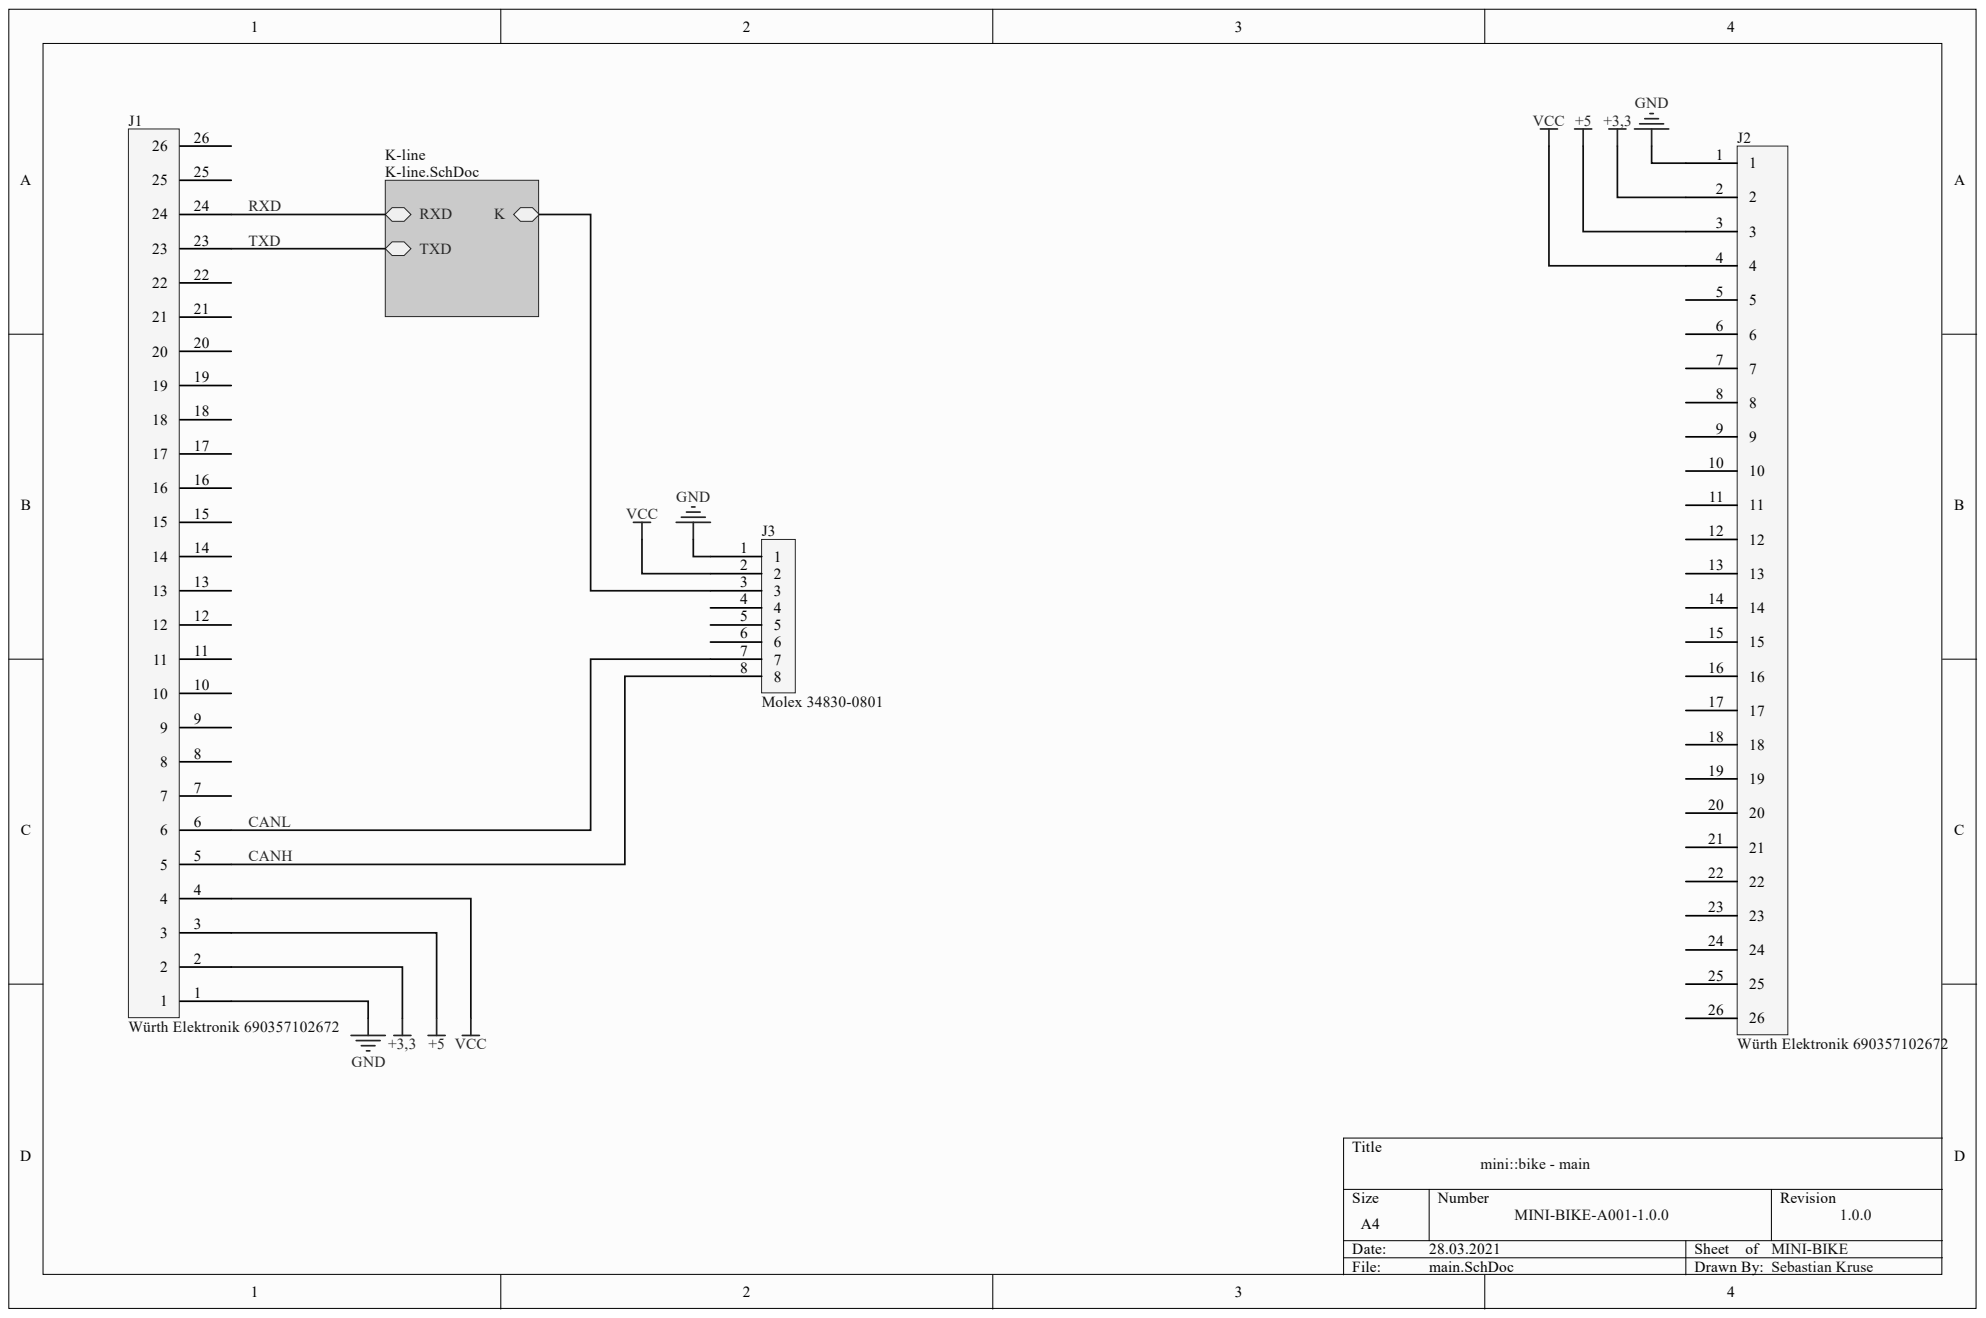
[picture p48: page 2]
Sheet o; VCC +5 +3,3; ian Kru; ke - mai; lex 3

3 PIJ103 PIJ103

2 PIJ102 PIJ102

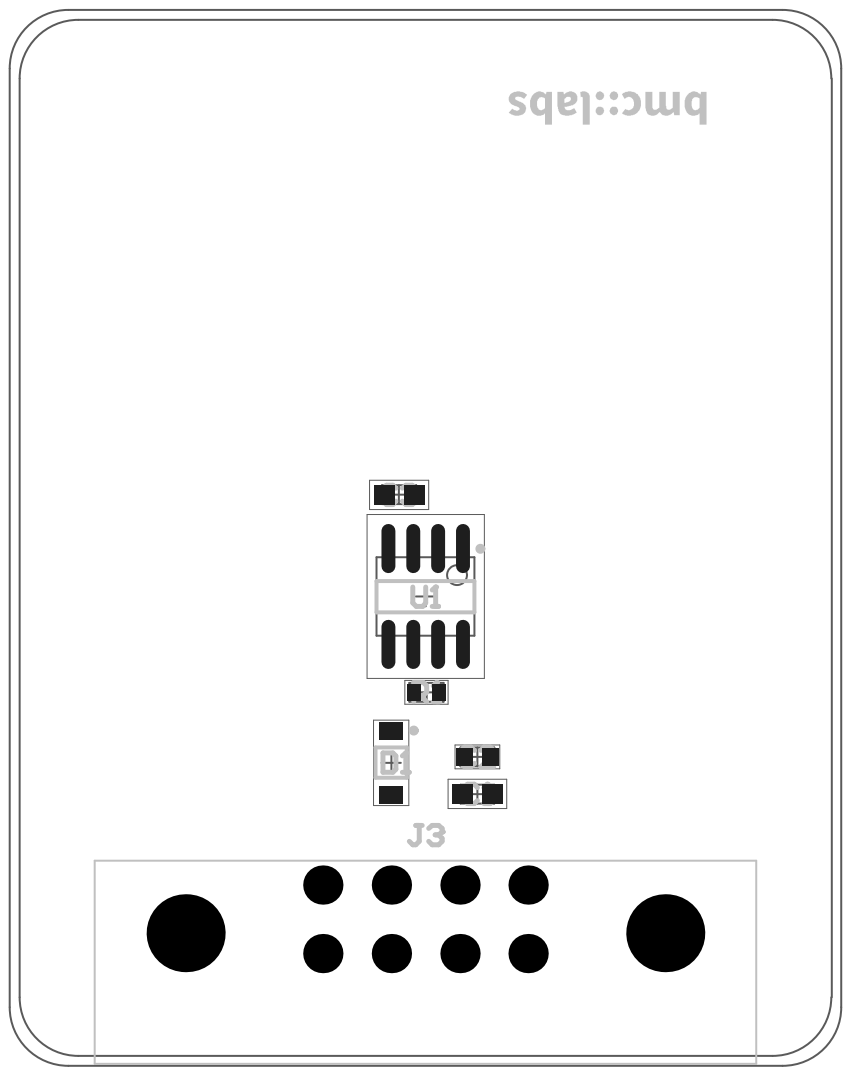
[picture p49: page 3]

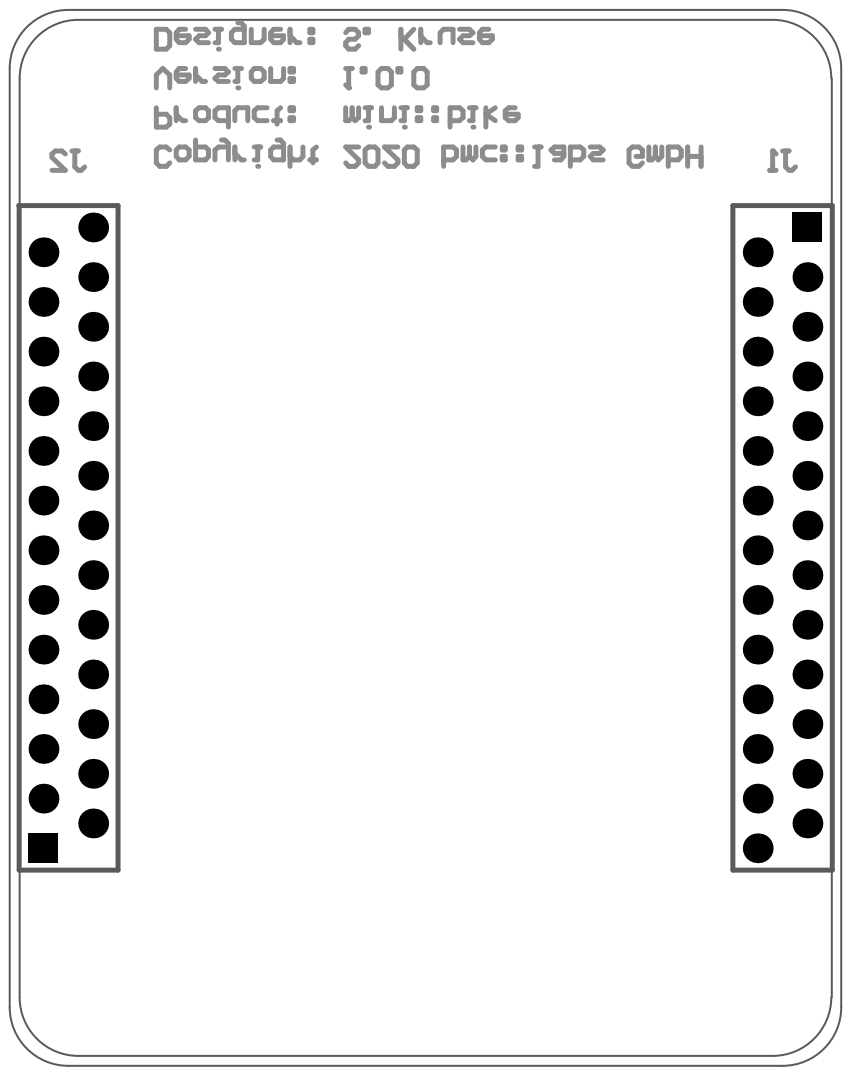
[picture p50: page 4]
