bocamobile/board-mini/(commit log)

2021-02-02 add pinout diagrams of mini::pit and mini::grid, directories for arduino example code
2021-03-11 Add board package for Arduino IDE
2021-03-11 Remove package file for Arduino
2021-03-11 Restructured repo and build a main README.md
    [BOM_PartType-MINI-BASE-A001-1-0-0.xls, BOM_PartType-MINI-OUT-A001-1-0-0.xls, Pick Place for MINI-BASE-A001-1.0.0.csv, Pick Place for MINI-GRID-A001-1.0.0.csv, Pick Place for MINI-OUT-A001-1.0.0.csv, Pick Place for MINI-PIT-A001-1-0-0.csv]
2021-03-12 Changed capital to small letters
    [MINI-GRID-A001-1-0-0.xls, MINI-PIT-A001-1-0-0.xls]
2021-03-12 Started with how to program a mini::base with Arduino
2021-03-28 Start to pull naming with dashes and underscore clean
    [BOM_PartType-MINI-BASE-A001-1-0-0.xls, BOM_PartType-MINI-OUT-A001-1-0-0.xls, MINI-GRID-A001-1-0-0.xls, MINI-PIT-A001-1-0-0.xls, Pick Place for MINI-BASE-A001-1.0.0.csv, Pick Place for MINI-GRID-A001-1.0.0.csv, Pick Place for MINI-OUT-A001-1.0.0.csv, Pick Place for MINI-PIT-A001-1-0-0.csv]
2021-03-28 Further rename all files increasingly with dash vs underscore
    [BOM-PartType-MINI-BASE-A001-1-0-0.xls, BOM-PartType-MINI-OUT-A001-1-0-0.xls]
2021-03-30 mini::bike design files and gsxr-test code
    [MINI-BIKE-A001-1-0-0-BOM.xls, Pick Place for MINI-BIKE-A001-1-0-0.csv, Pinout_List.ods]
