bocamobile/board-mini/(notices)

Notices in the files:
README.md:
alt="Creative Commons License"
src="https://i.creativecommons.org/l/by-sa/4.0/88x31.png"
